claudiusmarius/Smart-RGB-Quad-Pixel-Module-DFTA259/photo4.jpg

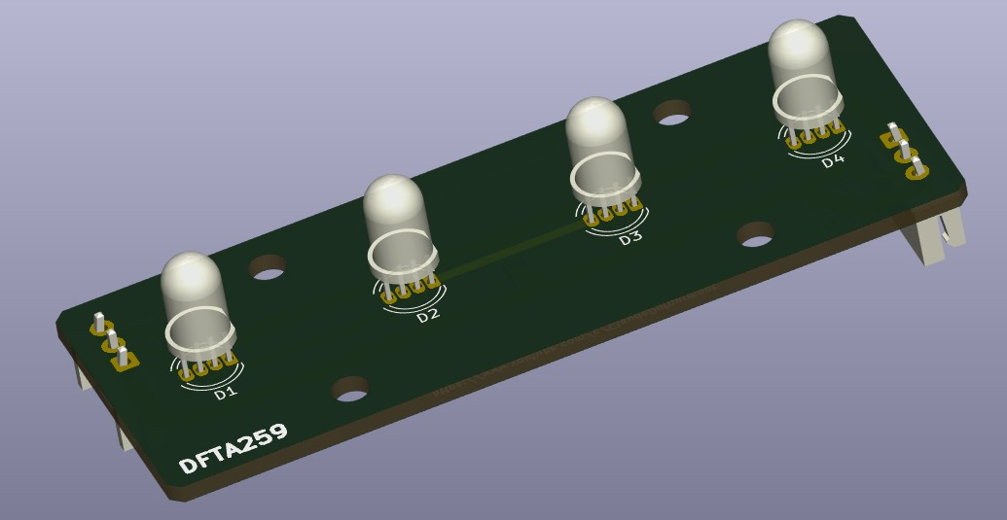
photo4.jpg
