claudiusmarius/Smart-RGB-Quad-Pixel-Module-DFTA259/photo1.jpg

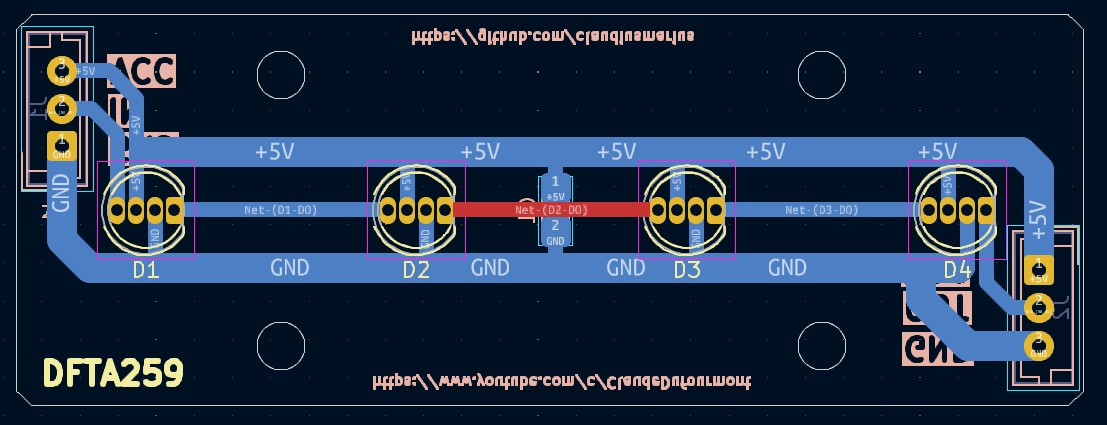
photo1.jpg
