claudiusmarius/Smart-RGB-Quad-Pixel-Module-DFTA259/README.md

# Smart-RGB-Quad-Pixel-Module-DFTA259

DFTA259-4RGB-5V
Barrette LED RGB 4x APA106 – 5V – Chaînable

DFTA259-4RGB-5V est une barrette LED RGB adressable conçue pour une intégration propre en face avant de projets électroniques.
Elle utilise 4 LEDs APA106 traversantes (5 mm) espacées de 18 mm, avec connectique JST 3 broches permettant le chaînage.
Ce module est destiné à être assemblé par la communauté à partir des fichiers fournis.
________________________________________
Caractéristiques principales

•	4 LEDs APA106 (24 bits par LED)

•	Alimentation 5VDC

•	Compatible protocole WS2812B

•	Connecteurs JST 3 broches entrée/sortie

•	Chaînage possible

•	PCB FR4 1.6 mm

•	Format optimisé pour faces avant
________________________________________
Compatibilité logicielle
Compatible avec la majorité des bibliothèques Arduino WS2812B :

•	FastLED

•	Adafruit NeoPixel

•	Autres bibliothèques WS2812B
________________________________________
Attention – Niveau logique
La ligne DATA doit impérativement être en 5V.
Pour les microcontrôleurs en 3.3V (ESP32, Seeeduino XIAO, etc.), utiliser par exemple un convertisseur de niveau logique type :
SN74AHCT125
________________________________________
Contenu du dépôt

•	Fichier Gerber

•	Schémas

•	BOM (liste composants)

•	Fiche technique PDF

•	Exemple de code (ATtiny85 / Seeeduino XIAO)
________________________________________
Licence
Open Hardware – usage libre pour projets personnels et communautaires.
________________________________________
À venir
Une version CMS utilisant des WS2812B sera prochainement publiée (nouvelle référence).
