claudiusmarius/Smart-RGB-Quad-Pixel-Module-DFTA259/ComposantsJPG.jpg

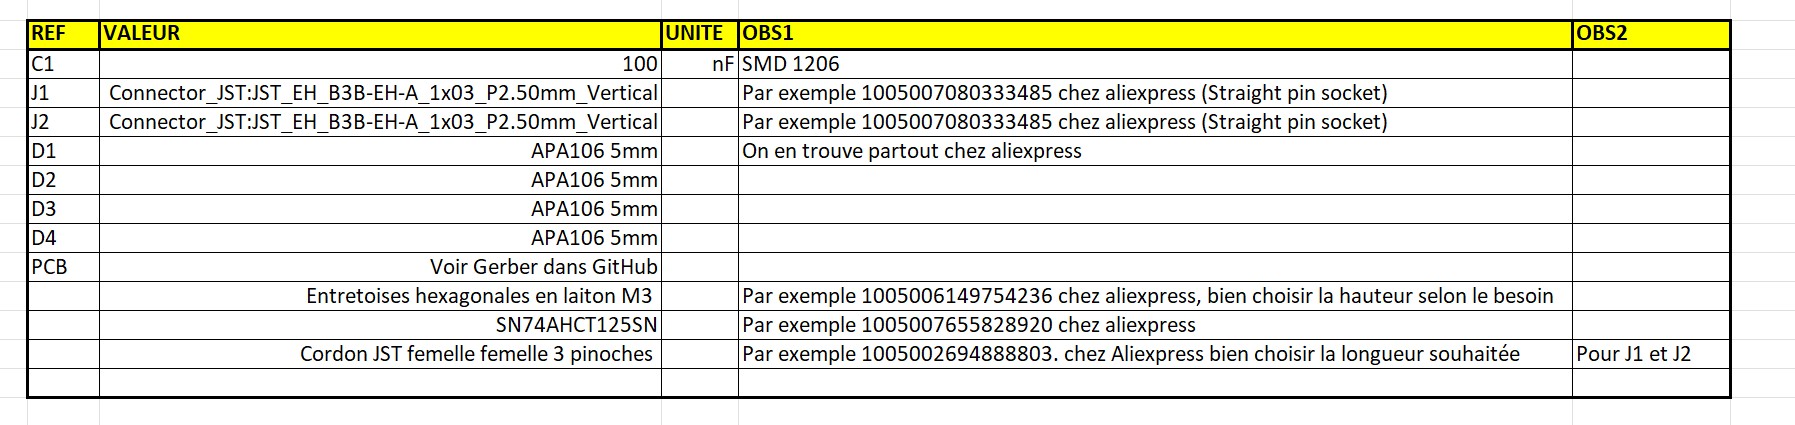
ComposantsJPG.jpg
