claudiusmarius/Smart-RGB-Quad-Pixel-Module-DFTA259/photo2.jpg

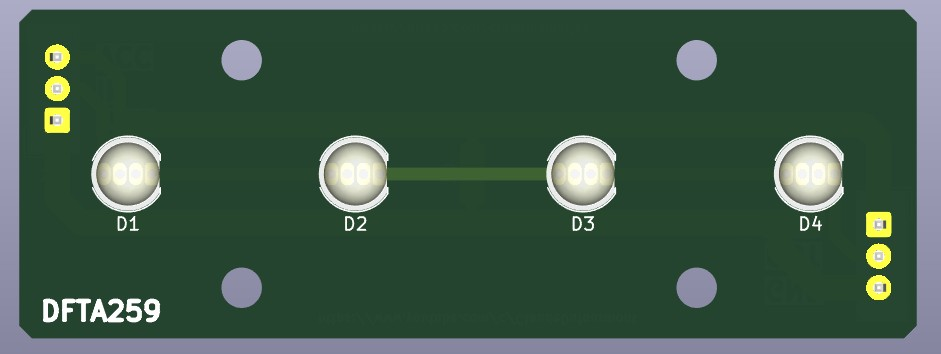
photo2.jpg
