claudiusmarius/Smart-RGB-Quad-Pixel-Module-DFTA259/photo3.jpg

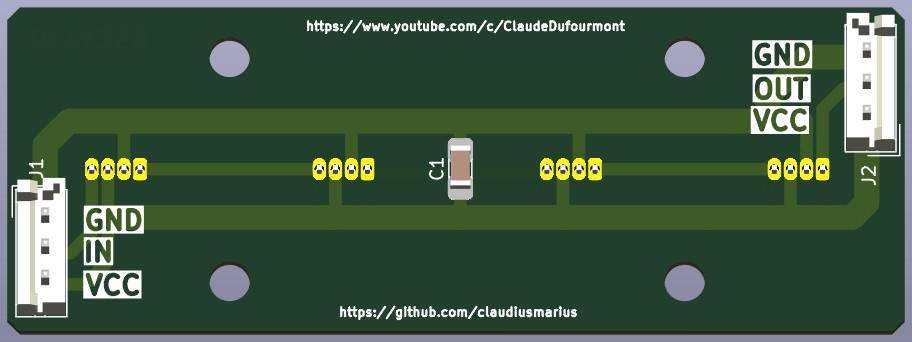
photo3.jpg
