claudiusmarius/Smart-RGB-Quad-Pixel-Module-DFTA259/ListeComposantsDFTA259.xlsx

Sheet: Feuil1
REF | VALEUR | UNITE | OBS1 | OBS2
C1 | 100 | nF | SMD 1206
J1 | Connector_JST:JST_EH_B3B-EH-A_1x03_P2.50mm_Vertical |  | Par exemple 1005007080333485 chez aliexpress (Straight pin socket)
J2 | Connector_JST:JST_EH_B3B-EH-A_1x03_P2.50mm_Vertical |  | Par exemple 1005007080333485 chez aliexpress (Straight pin socket)
D1 | APA106 5mm |  | On en trouve partout chez aliexpress
D2 | APA106 5mm
D3 | APA106 5mm
D4 | APA106 5mm
PCB | Voir Gerber dans GitHub
 | Entretoises hexagonales en laiton M3 |  | Par exemple 1005006149754236 chez aliexpress, bien choisir la hauteur selon le besoin
 | SN74AHCT125SN |  | Par exemple 1005007655828920 chez aliexpress
 | Cordon JST femelle femelle 3 pinoches |  | Par exemple 1005002694888803. chez Aliexpress bien choisir la longueur souhaitée | Pour J1 et J2

Sheet: Feuil2
1228229 | 7773291
1228230 | 9176626
1228231 | 1228231
 | 1228230
 | 1228229
 | 1446290
 | 7577239
