claudiusmarius/Smart-RGB-Quad-Pixel-Module-DFTA259/Plan.pdf

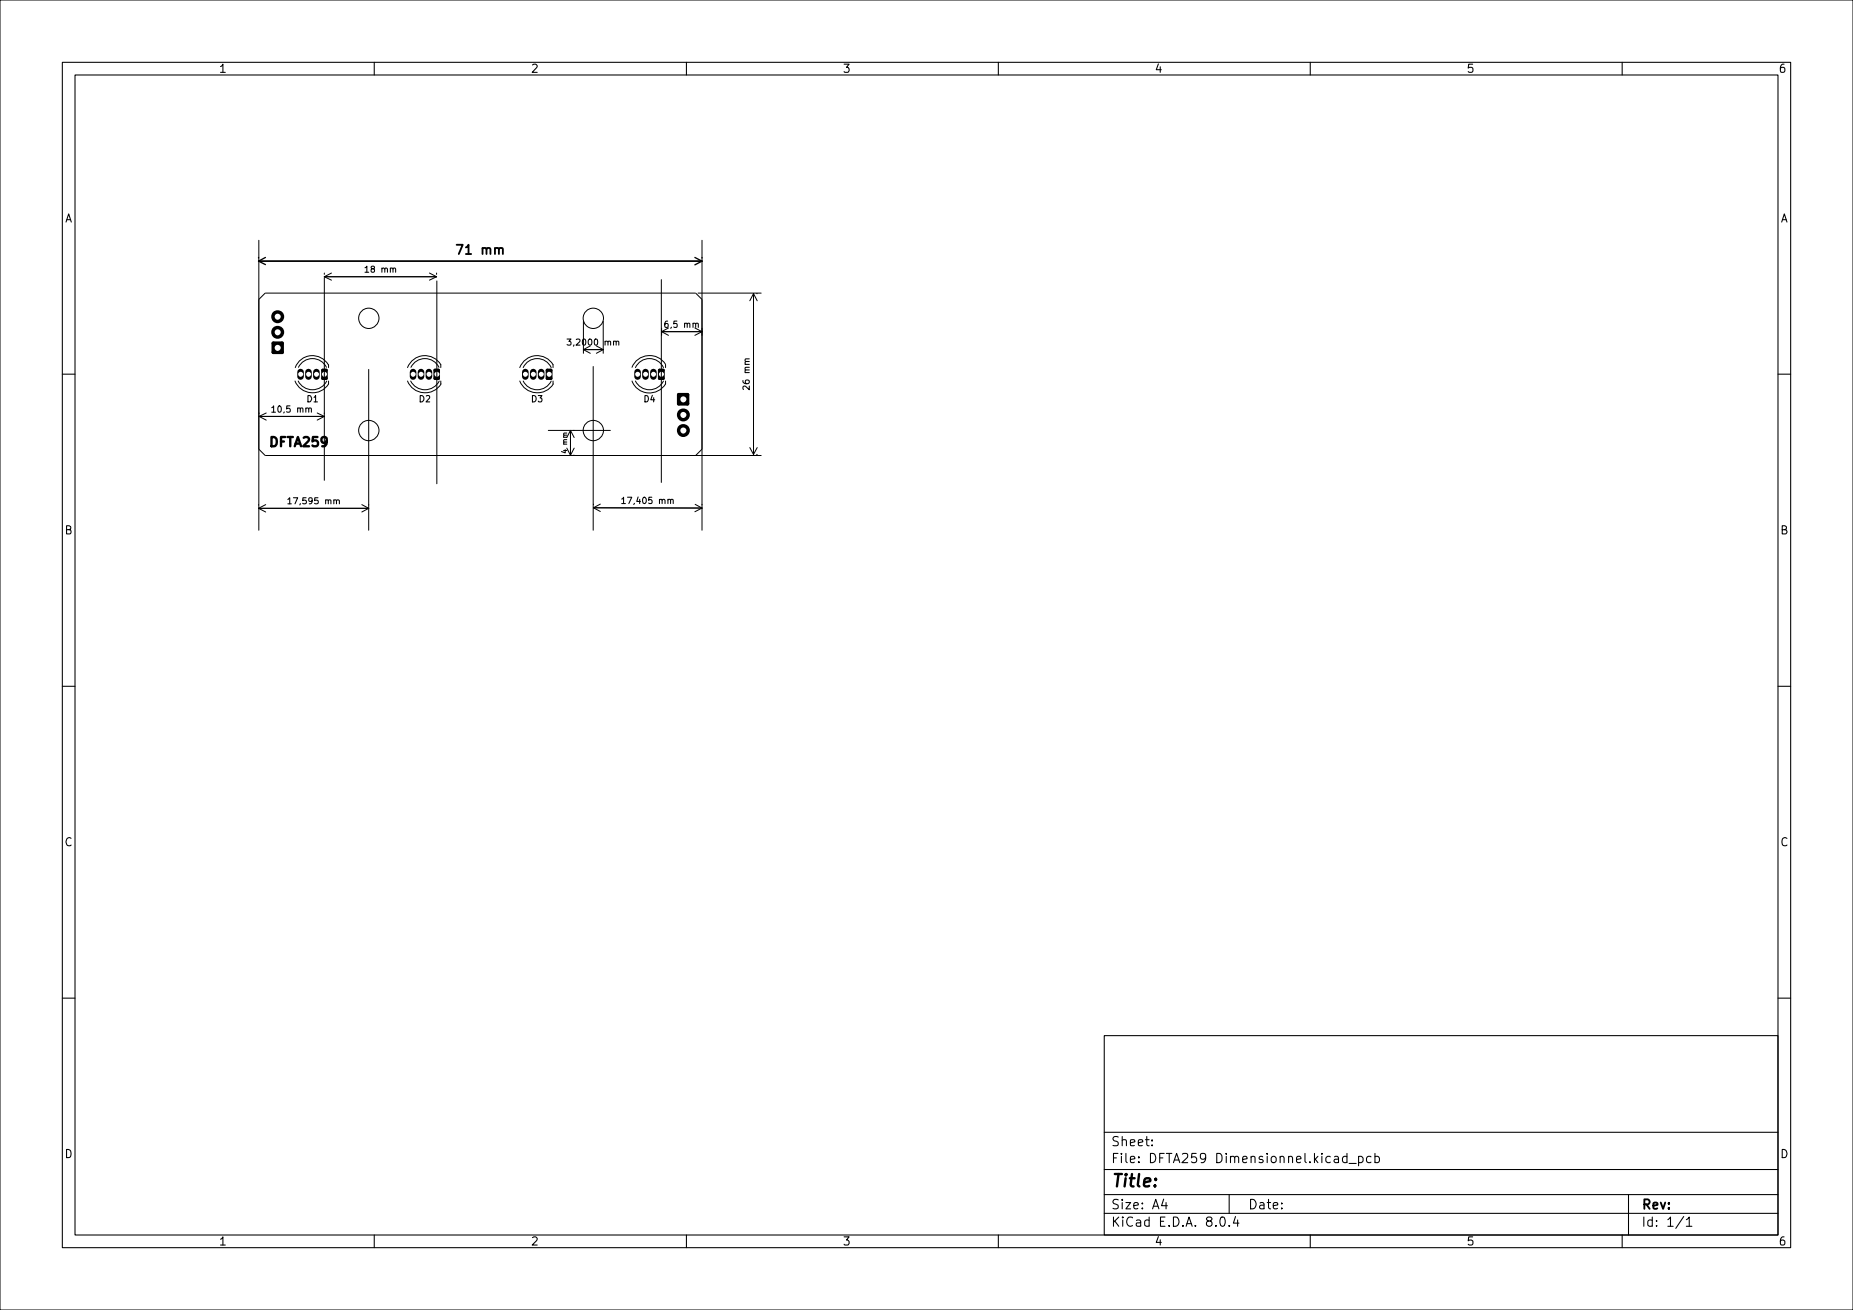
[picture p9: page 1]
