claudiusmarius/Smart-RGB-Quad-Pixel-Module-DFTA259/SchémaDFTA259.pdf

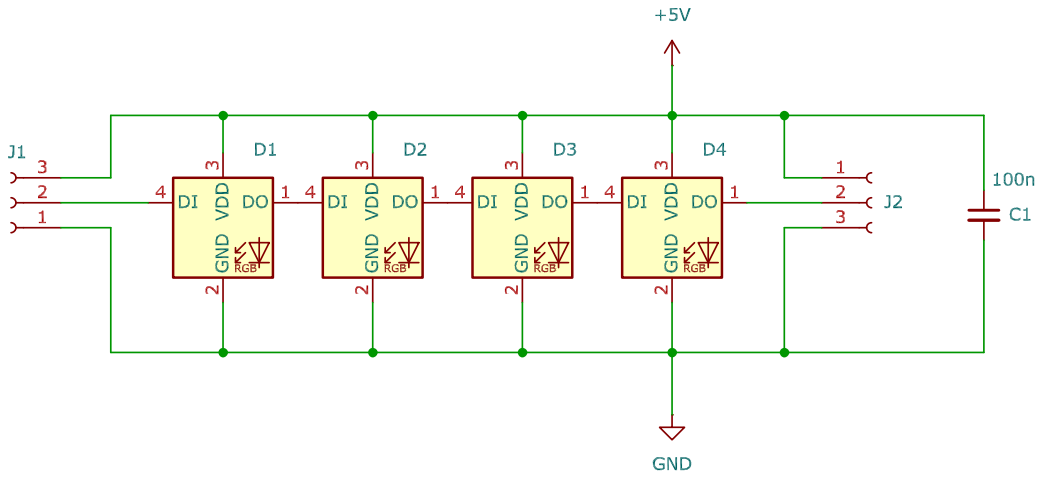
[picture p10: page 1]
